mhamzai/FYP-Smart-Hosptial-Bed/Images/Ik4kWeMAiw.png

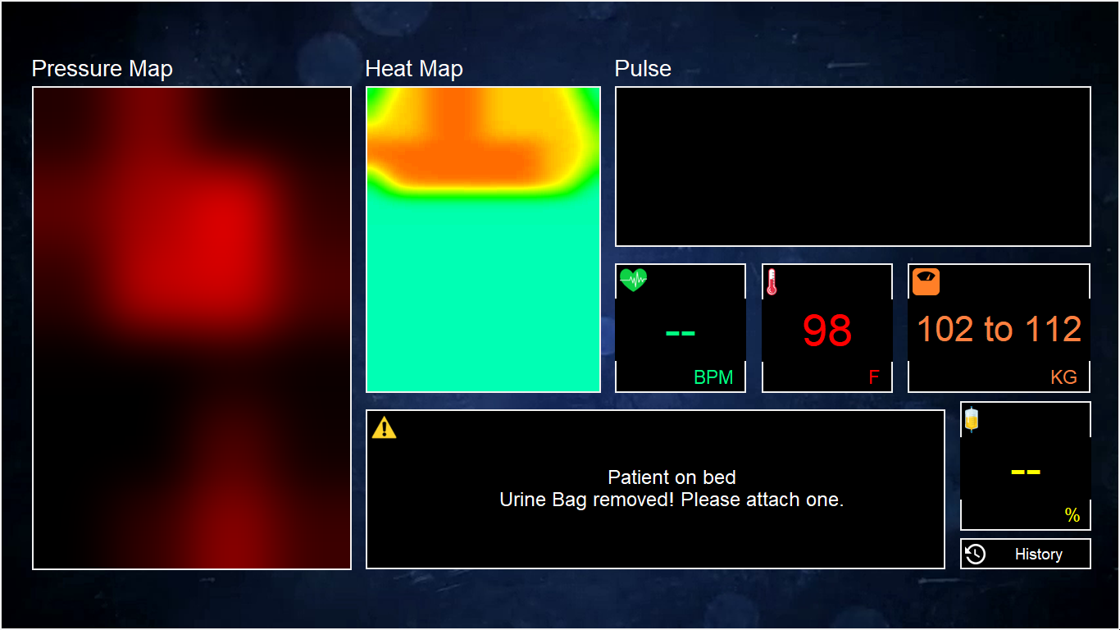
Images/Ik4kWeMAiw.png
