mhamzai/FYP-Smart-Hosptial-Bed/Images/IMG_20210320_221435_542.jpg

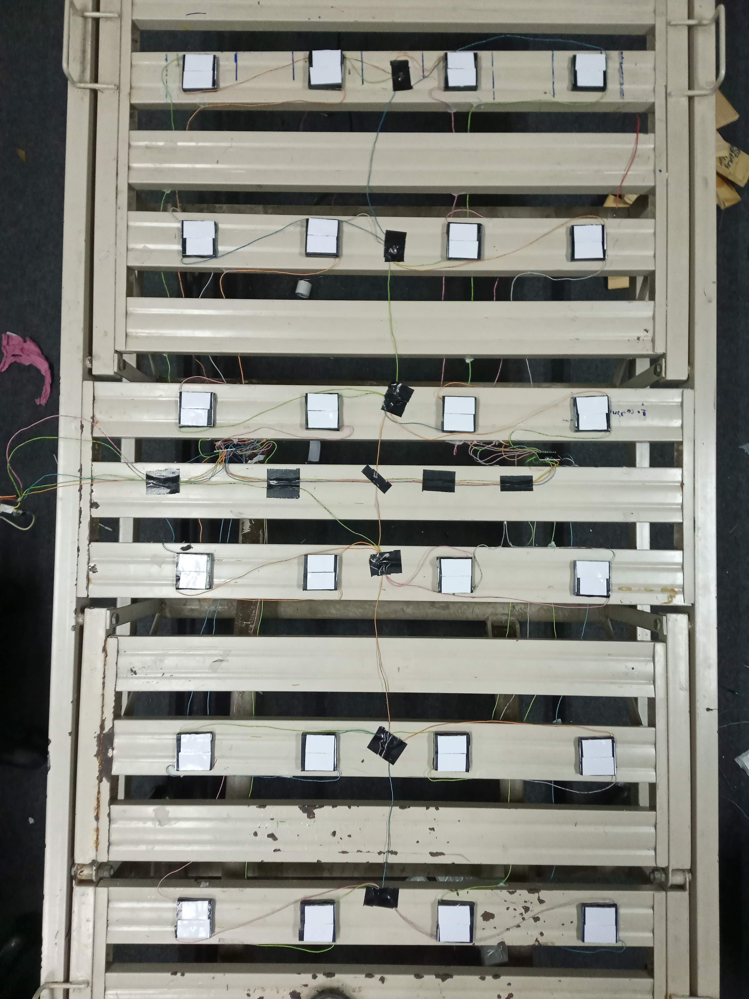
Images/IMG_20210320_221435_542.jpg
