mhamzai/FYP-Smart-Hosptial-Bed/Arduino/CapRead/Adafruit_MPR121_STM32-master/README.md

# Adafruit MPR121 Library 



This is a library for the Adafruit MPR121 Capacitive touch sensor breakout:
  * https://www.adafruit.com/products/1982
 
Check out the links above for our tutorials and wiring diagrams. This chip uses I2C to communicate

Modified to use SoftWire library on STM32

Adafruit invests time and resources providing this open source code, please support Adafruit and open-source hardware by purchasing products from Adafruit!

Written by Limor Fried/Ladyada for Adafruit Industries.
MIT license, all text above must be included in any redistribution
