mhamzai/FYP-Smart-Hosptial-Bed/NeuralNetwork/Body Detection - Accuracy.png

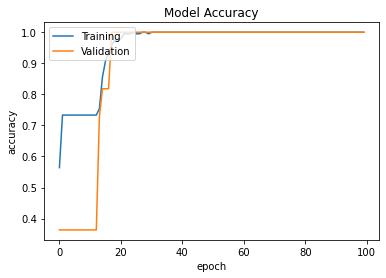
NeuralNetwork/Body Detection - Accuracy.png
