mhamzai/FYP-Smart-Hosptial-Bed/NeuralNetwork/Body Detection - Loss.png

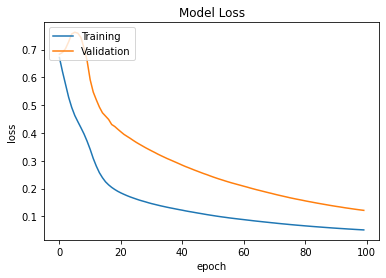
NeuralNetwork/Body Detection - Loss.png
