mhamzai/FYP-Smart-Hosptial-Bed/NeuralNetwork/Weight Estimation - Loss.png

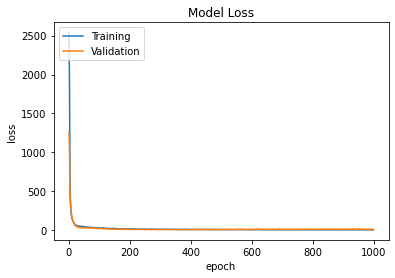
NeuralNetwork/Weight Estimation - Loss.png
