mhamzai/FYP-Smart-Hosptial-Bed/User_Interface/Heartbeat.png

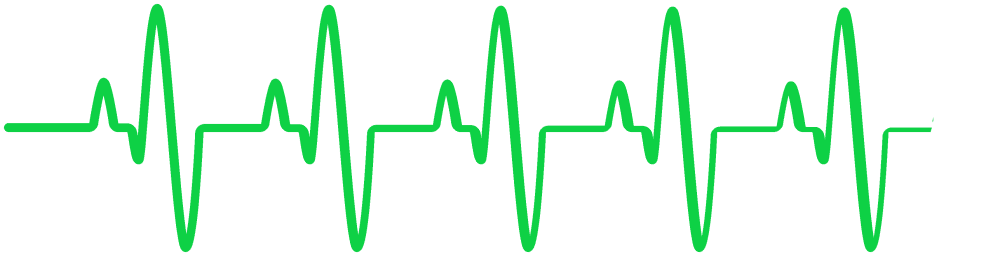
User_Interface/Heartbeat.png
