mhamzai/FYP-Smart-Hosptial-Bed/UserInterface/grafana/grafana/public/testdata/js_libraries.csv

Library | Github Stars | Forks | Watchers
React.js | 169000 | 34000 | 6700
Vue | 184000 | 29100 | 6300
Angular | 73400 | 19300 | 3200
JQuery | 54900 | 20000 | 3300
Meteor | 42400 | 5200 | 1700
Aurelia | 11600 | 684 | 442
