mhamzai/FYP-Smart-Hosptial-Bed/UserInterface/grafana/grafana/public/testdata/population_by_state.csv

State | 2020 | 2000 | 1980
California | 39368078 | 33987977 | 23800800
Texas | 29360759 | 20944499 | 14338208
Florida | 21733312 | 16047515 | 9839835
