mhamzai/FYP-Smart-Hosptial-Bed/Heartbeat/Heartbeat/BoneDevice/Src/main.c

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

/* Includes ------------------------------------------------------------------*/
#include "main.h"
#include "usb_device.h"

/* USER CODE BEGIN Includes */
#include "usbd_cdc_if.h"
#include <string.h>
#include <stdio.h>
/* USER CODE END Includes */

ADC_HandleTypeDef hadc1;
DMA_HandleTypeDef hdma_adc1;

RTC_HandleTypeDef hrtc;

TIM_HandleTypeDef htim1;

/* USER CODE BEGIN PV */
ValueBuf adcBuff;

/* USER CODE END PV */

void SystemClock_Config(void);
static void MX_GPIO_Init(void);
static void MX_DMA_Init(void);
static void MX_ADC1_Init(void);
static void MX_TIM1_Init(void);
static void MX_RTC_Init(void);
/* USER CODE BEGIN 0 */
void HAL_TIM_PeriodElapsedCallback(TIM_HandleTypeDef *htim)
{
	if (htim->Instance==TIM1) {
		HAL_ADC_Start_DMA(&hadc1,(unsigned int *)&(adcBuff.data[adcBuff.tail++][2]),4);
		
		adcBuff.tail%=16;
	}
}

/* USER CODE END 0 */

/**
  * @brief  The application entry point.
  * @retval int
  */
int main(void)
{ 
  /* MCU Configuration--------------------------------------------------------*/

  /* Reset of all peripherals, Initializes the Flash interface and the Systick. */
  HAL_Init();

  /* Configure the system clock */
  SystemClock_Config();

  /* Initialize all configured peripherals */
  MX_GPIO_Init();
  MX_DMA_Init();
  MX_ADC1_Init();
  MX_USB_DEVICE_Init();
  MX_TIM1_Init();
  MX_RTC_Init();
  /* USER CODE BEGIN 2 */
	memset((void*) &adcBuff,0,sizeof(adcBuff));
	for (int i=0;i<16;i++) {
		adcBuff.data[i][0]=0x1b1b;
		adcBuff.data[i][1]=0x0;
	}
	HAL_TIM_Base_Init(&htim1);
	HAL_TIM_Base_Start_IT(&htim1);
	unsigned short temp = 0;
  /* USER CODE END 2 */

  /* Infinite loop */
  /* USER CODE BEGIN WHILE */
  while (1)
  {
		if (adcBuff.head!=adcBuff.tail) { 
			CDC_Transmit_FS((uint8_t*)&adcBuff.data[adcBuff.head][1], 8);
			adcBuff.data[adcBuff.head][1] = temp;
			temp++;
			adcBuff.head++;
			adcBuff.head%=16;
		}

    /* USER CODE END WHILE */

    /* USER CODE BEGIN 3 */
  }
  /* USER CODE END 3 */
}

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
