mhamzai/FYP-Smart-Hosptial-Bed/(commit log)

2020-11-14 IR_Read.ino: Changed temperature calculation algo
    Added and modified formula to use bodyTemp before
    body is detected as previousTemp to be used in calculation
    for estiamted temperature of patient only
2020-11-14 IR_Read.ino: Added ultraSound sensor support for area calculation
    Added ultrasound hc04 which reads distance directly parallel to IR
    sensor and then calculate the area using the distance then this area
    is used to calculate body ratio to estimate body temperature
2021-01-01 IR_Read.ino: Added support for body area calculation
    Added function which reads capacitor values from STM32
    provided by mpr121
    Added function split_message to split and store values
    from serial into floats
    Updated bodyArea function which calculates area based
    on capacitor values read.
2021-01-02 IR_Read.ino: Introduced I2C comm. replacing serial
    Removed serial2 communication due to dataloss/ sync issues
    Introduced I2C communication to replace serial2
    Added Event trigger for I2C communication and modified
    bodyArea() function to make it compatible with event
    triggered function
2021-01-02 IR_Read.ino: Added I2C communication ending check
    Added a check in event triggered function to check if
    all data stream is ended successfully with end symbol
2021-01-02 IR_Read.ino: Added decompression to use 8bit transmission
    Added shift left to decompresses values compressed from 10
    to 8 bits to be transfered on 8bit channel of I2C and use
    those to determine covered area by patient wrt. total area
2021-01-09 Added STM32 Bootloader and Programmer setup
    Added setup for ST-LINK programmer
    Added Bootloader for STM32 bluepill
    [flash.cfg, stm32.cfg]
2021-04-10 IR_READ.ino: Introduced TwoWire Wire1 for 2nd I2C
    To use 2nd I2C code is ported to use TwoWire Wire1
    object which will use second I2C interface on Arduino
    Duo. Ported from Arduino Mega due to unavailability of
    2 I2C interfaces.
2021-04-16 IR_Read.ino: Added HAL code for arduino due
    Due to ARM architecture Arduino Due was unable to use
    wire.h for communication with i2c therefore HAL code
    has been used.
2021-04-17 IR_Read.ino:Included STM32 Cores library
    STM32 Library allows us to use Wire.h
