mhamzai/FYP-Smart-Hosptial-Bed/(notices)

Notices in the files:
Arduino/IRRead/IRRead.ino:
This program is free software: you can redistribute it and/or modify
it under the terms of the GNU General Public License as published by
the Free Software Foundation, either version 3 of the License, or
(at your option) any later version.
Heartbeat/Heartbeat/BoneDevice/Src/main.c:
© Copyright (c) 2019 STMicroelectronics.
All rights reserved.
This software component is licensed by ST under Ultimate Liberty license
(C) COPYRIGHT STMicroelectronics *****END OF FILE
